david-pi3141/Proyecto-Final-Robotica-Industrial-Automatizacion-del-Proceso-de-Ensamblaje/images/hmi.png

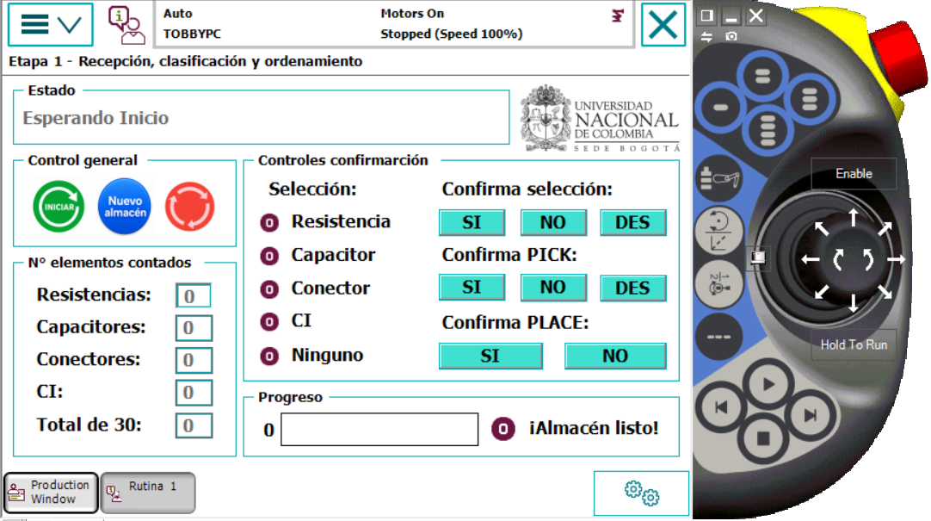
images/hmi.png
