david-pi3141/Proyecto-Final-Robotica-Industrial-Automatizacion-del-Proceso-de-Ensamblaje/Anexos/Plano_Herramienta_Electroiman.pdf

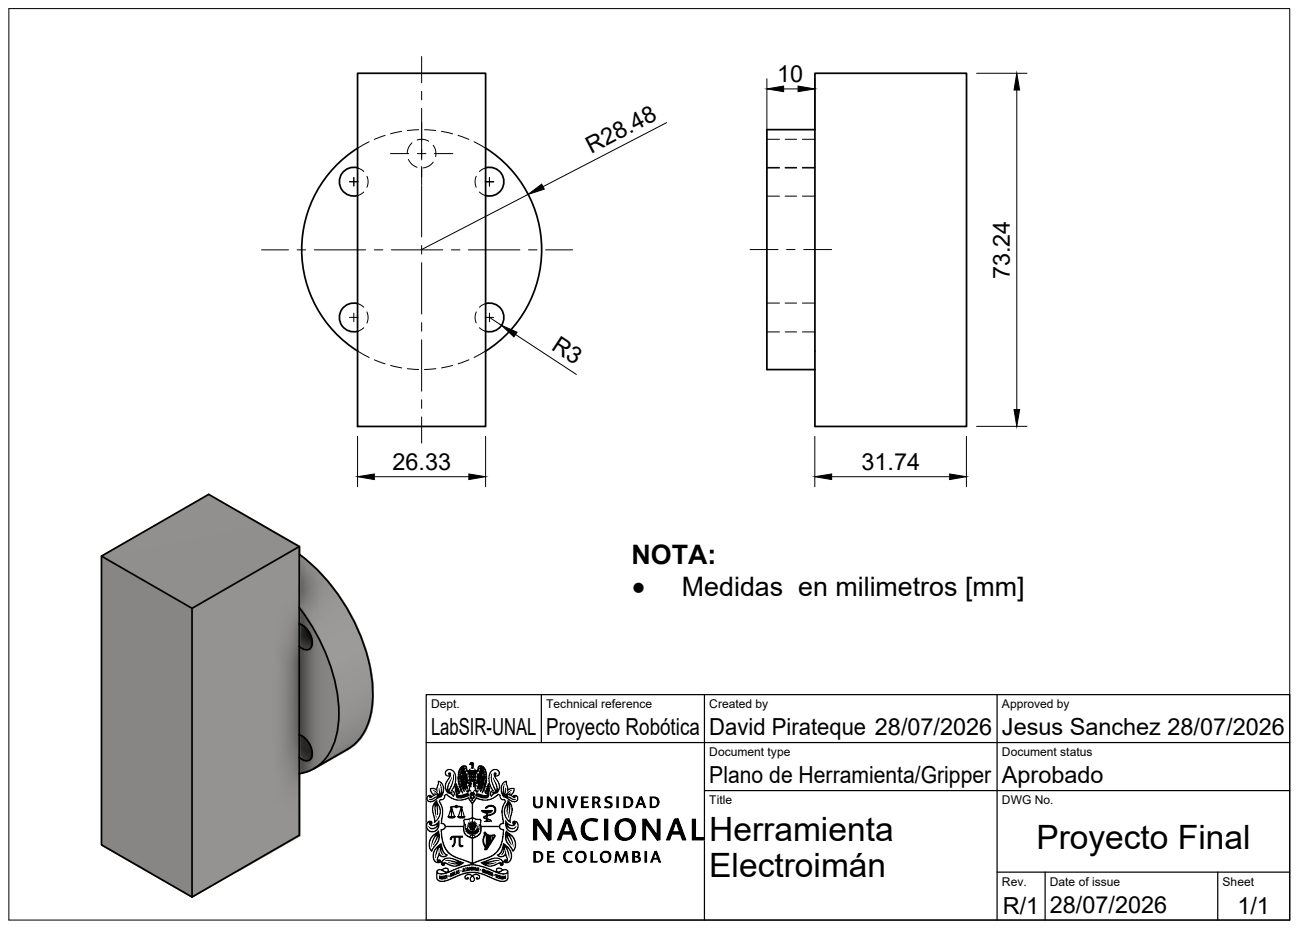
[picture p40: page 1]

NOTA:
· Medidas en milimetros [mm]

Dept. LabSIR-UNAL | Technical reference Proyecto Robótica | Created by David Pirateque 28/07/2026 | Approved by Jesus Sanchez 28/07/2026

Document type Plano de Herramienta/Gripper | Document status Aprobado

Title Herramienta Electroimán | DWG No. Proyecto Final

Rev. R/1 | Date of issue 28/07/2026 | Sheet 1/1
