david-pi3141/Proyecto-Final-Robotica-Industrial-Automatizacion-del-Proceso-de-Ensamblaje/(commit log)

2026-07-28 [Update] Vision de maquina
2026-07-28 [Update] Video y vision de maquina
2026-07-28 Requerimientos y D. de flujo
2026-07-29 Expand README with end effector tool details
    Added detailed information about the end effector tool, including selection, design, 3D modeling, assembly, dimensional verification, and used screws.
2026-07-29 Fix PDF link for Gripper tool plan
    Updated the PDF reference for the Gripper tool plan from 'Plano_Gripper.pdf' to 'Herramienta Electroimán.pdf'.
2026-07-29 Update README with tool and assembly details
2026-07-29 Document initial gripper design and its limitations
    Added initial design considerations for a 12V electromagnet gripper, including CAD model and 3D printed coupling images. Explained the limitations of the electromagnet's lifting capability and the decision to use a different solution.
2026-07-29 Add flow diagrams section to README
    Added section on flow diagrams for the process.
