david-pi3141/Proyecto-Final-Robotica-Industrial-Automatizacion-del-Proceso-de-Ensamblaje/images/Gripper_Detalle_1.jpg

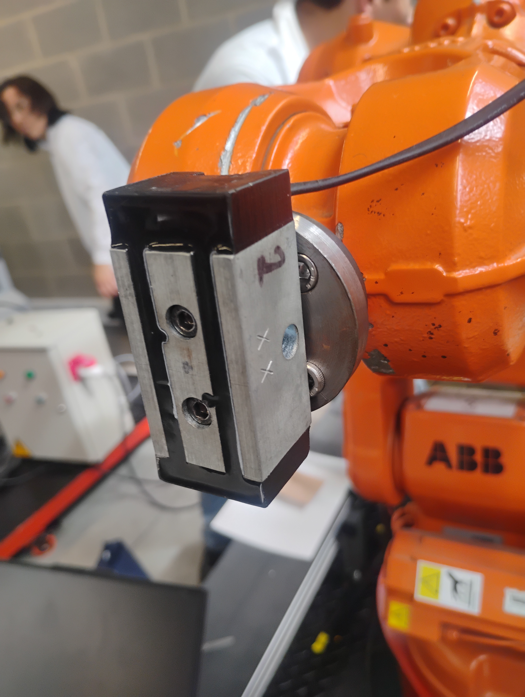
[picture p20: images/Gripper_Detalle_1.jpg]
images/Gripper_Detalle_1.jpg
