david-pi3141/Proyecto-Final-Robotica-Industrial-Automatizacion-del-Proceso-de-Ensamblaje/images/Gripper_Detalle_3.jpg

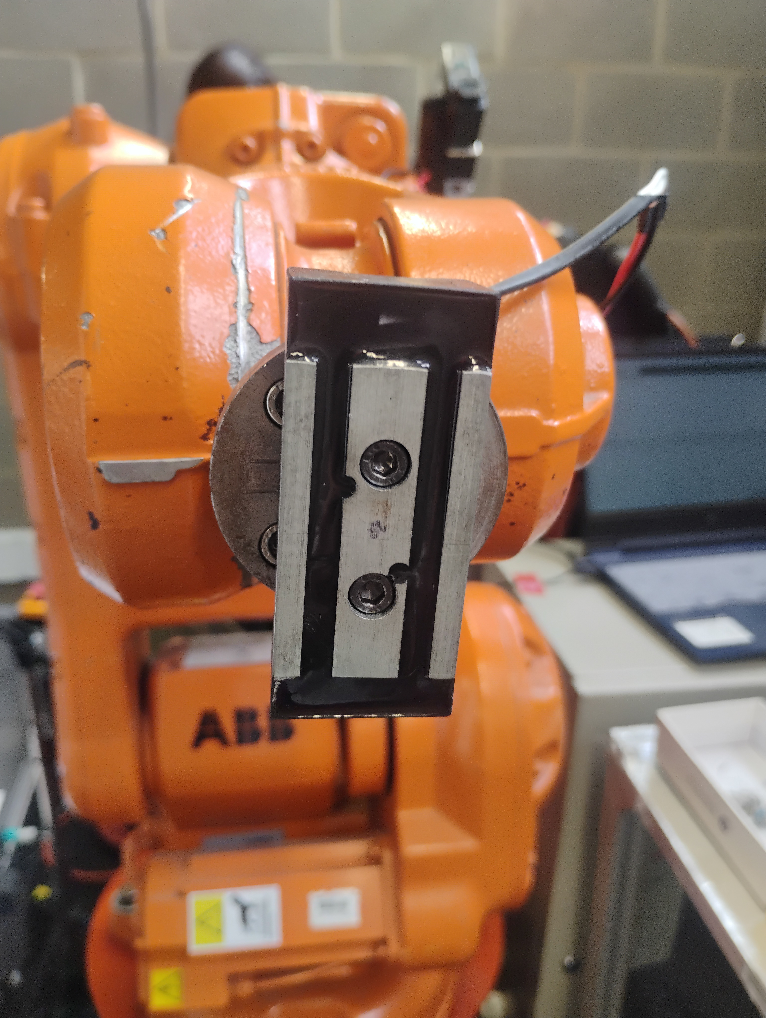
[picture p22: images/Gripper_Detalle_3.jpg]
images/Gripper_Detalle_3.jpg
