david-pi3141/Proyecto-Final-Robotica-Industrial-Automatizacion-del-Proceso-de-Ensamblaje/images/Montaje.jpeg

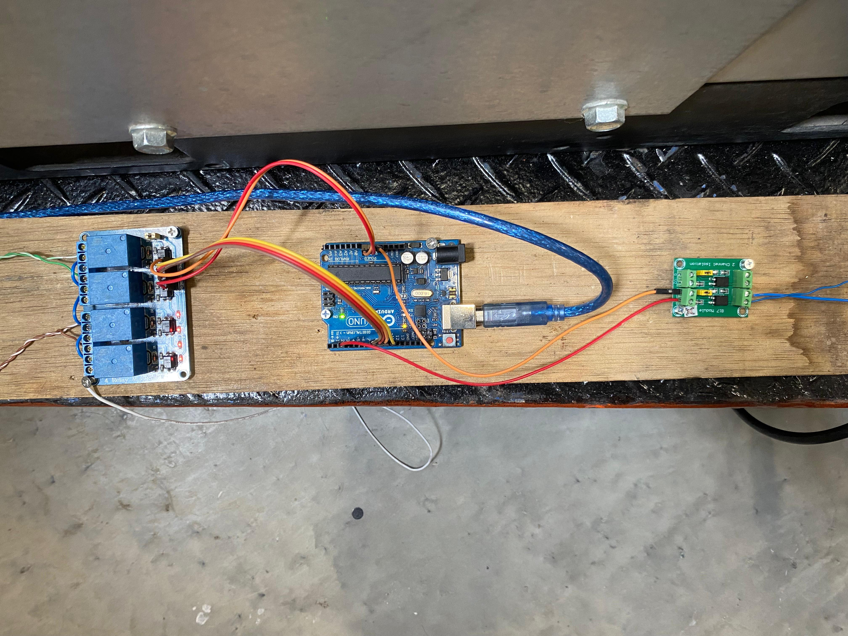
[picture p38: images/Montaje.jpeg]
images/Montaje.jpeg
